moden3/tamanori_robot/CAD/V2/玉乗りロボット.SLDASM

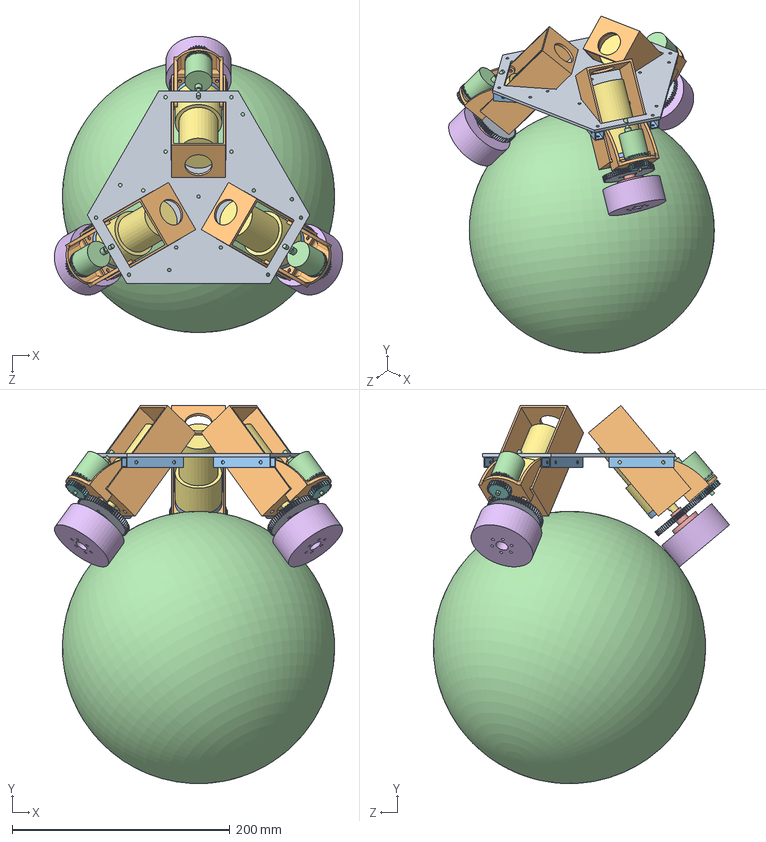
[picture p1: CAD file, 2019-08-27]
CAD/V2/玉乗りロボット.SLDASM
264.7 x 347.1 x 272.0 mm
土台1段目板
モータエンコーダ取り付け角柱 x 3
土台と脚取り付け角柱 x 6
E6A2_CW3C x 3
オムニ用ハブ x 3
オムニホイール x 3
モータ_ツカサ電工 x 3
エンコーダ歯車 x 3
モータ伝達歯車 x 3
エンコーダ取付3D部品 x 3
モータ取り付けアクリル板 x 3
球
