moden3/tamanori_robot/CAD/V2/アクリル用/切り出し用.SLDASM

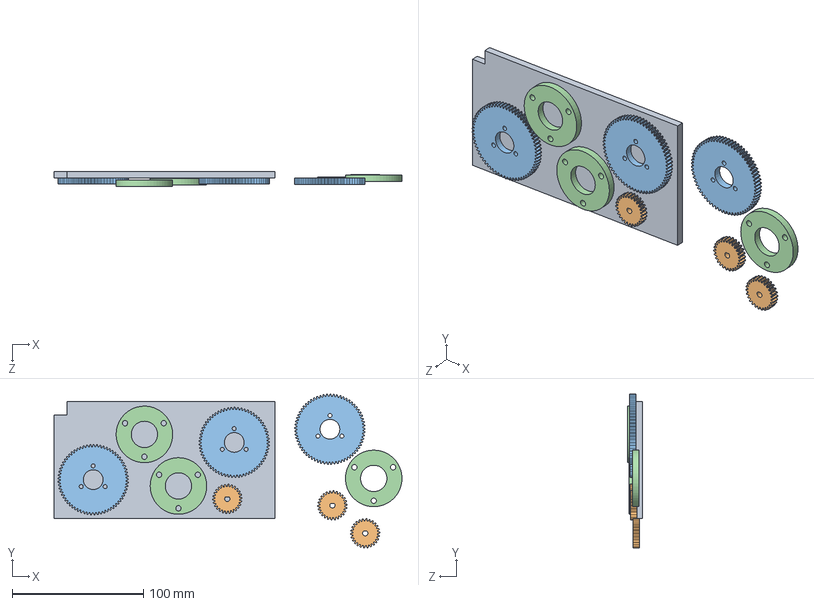
[picture p2: CAD file, 2019-07-12]
CAD/V2/アクリル用/切り出し用.SLDASM
264.7 x 117.1 x 11.4 mm
板1
エンコーダ歯車 x 3
モータ伝達歯車 x 3
モータ取り付けアクリル板 x 3
