moden3/tamanori_robot/CAD/V2/ワイヤ放電用/土台_ワイヤ放電.SLDASM

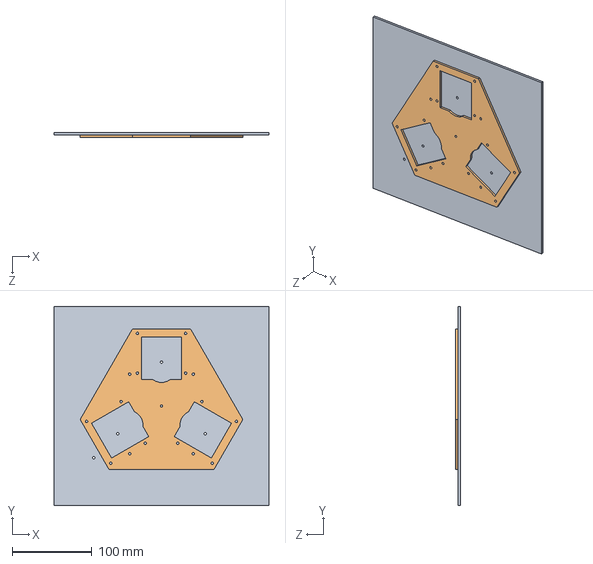
[picture p3: CAD file, 2019-07-12]
CAD/V2/ワイヤ放電用/土台_ワイヤ放電.SLDASM
270.0 x 250.0 x 6.00 mm
土台切り出し用板
土台1段目板
