moden3/tamanori_robot/CAD/V2/脚ユニット.SLDASM

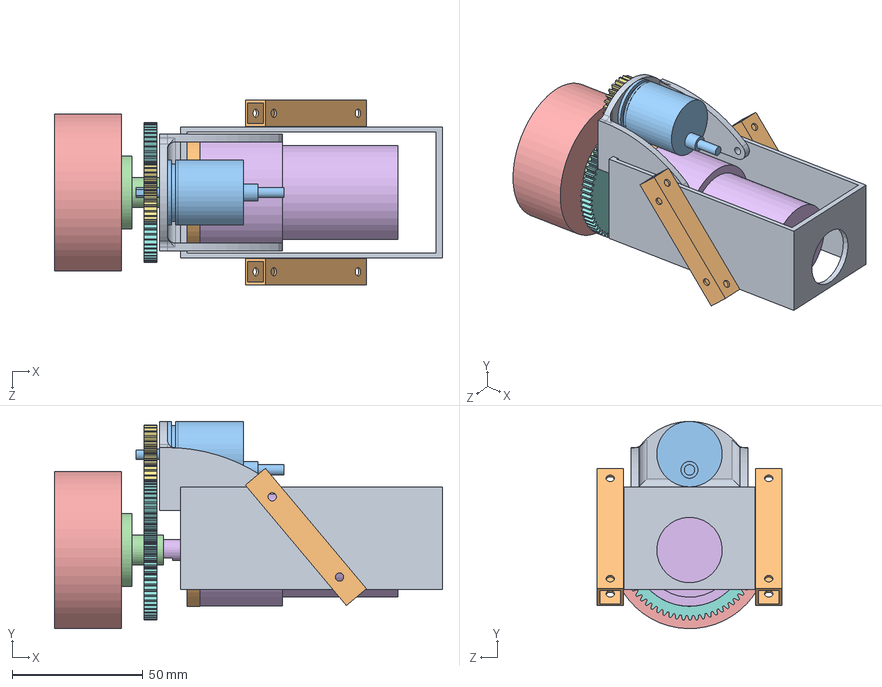
[picture p4: CAD file, 2019-08-19]
CAD/V2/脚ユニット.SLDASM
148.1 x 79.1 x 70.5 mm
モータエンコーダ取り付け角柱
土台と脚取り付け角柱 x 2
E6A2_CW3C
オムニ用ハブ
オムニホイール
モータ_ツカサ電工
エンコーダ歯車
モータ伝達歯車
エンコーダ取付3D部品
モータ取り付けアクリル板
