moden3/tamanori_robot/CAD/V2/ワイヤ放電用/土台切り出し用板.SLDPRT

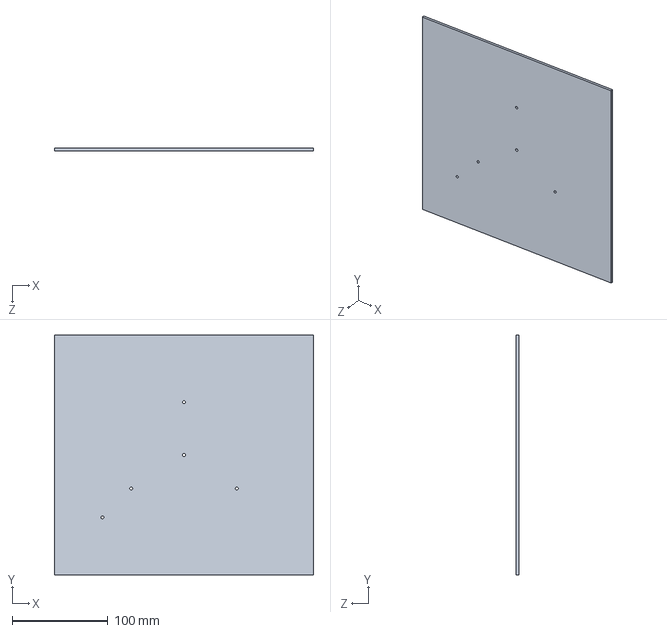
[picture p6: CAD file, 2019-07-12]
CAD/V2/ワイヤ放電用/土台切り出し用板.SLDPRT
270.0 x 250.0 x 3.00 mm
