moden3/tamanori_robot/CAD/V2/球.SLDPRT

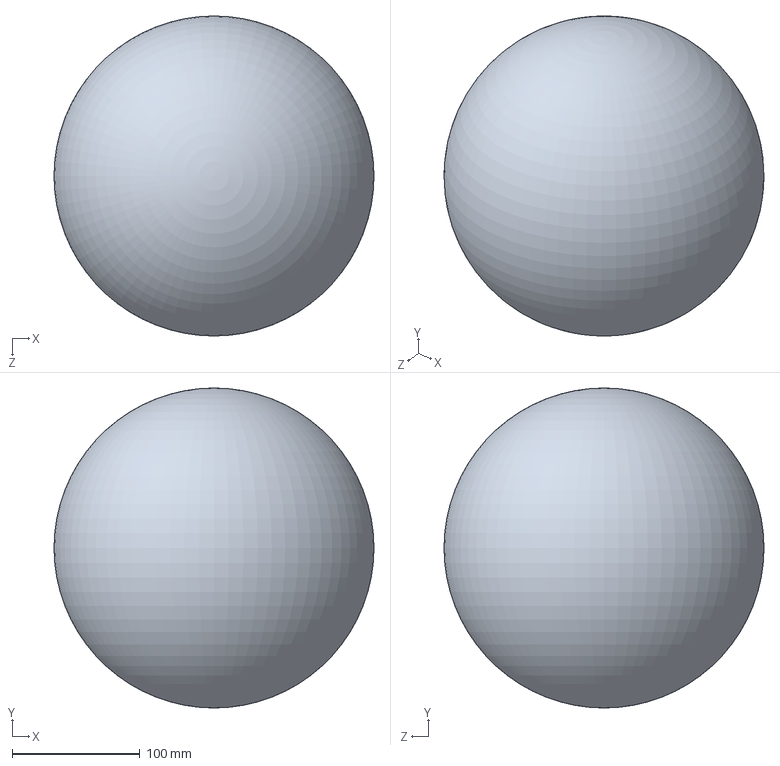
[picture p7: CAD file, 2019-08-27]
CAD/V2/球.SLDPRT
250.0 x 250.0 x 250.0 mm
