moden3/tamanori_robot/CAD/V2/アクリル用/切り出し用_V3.DXF

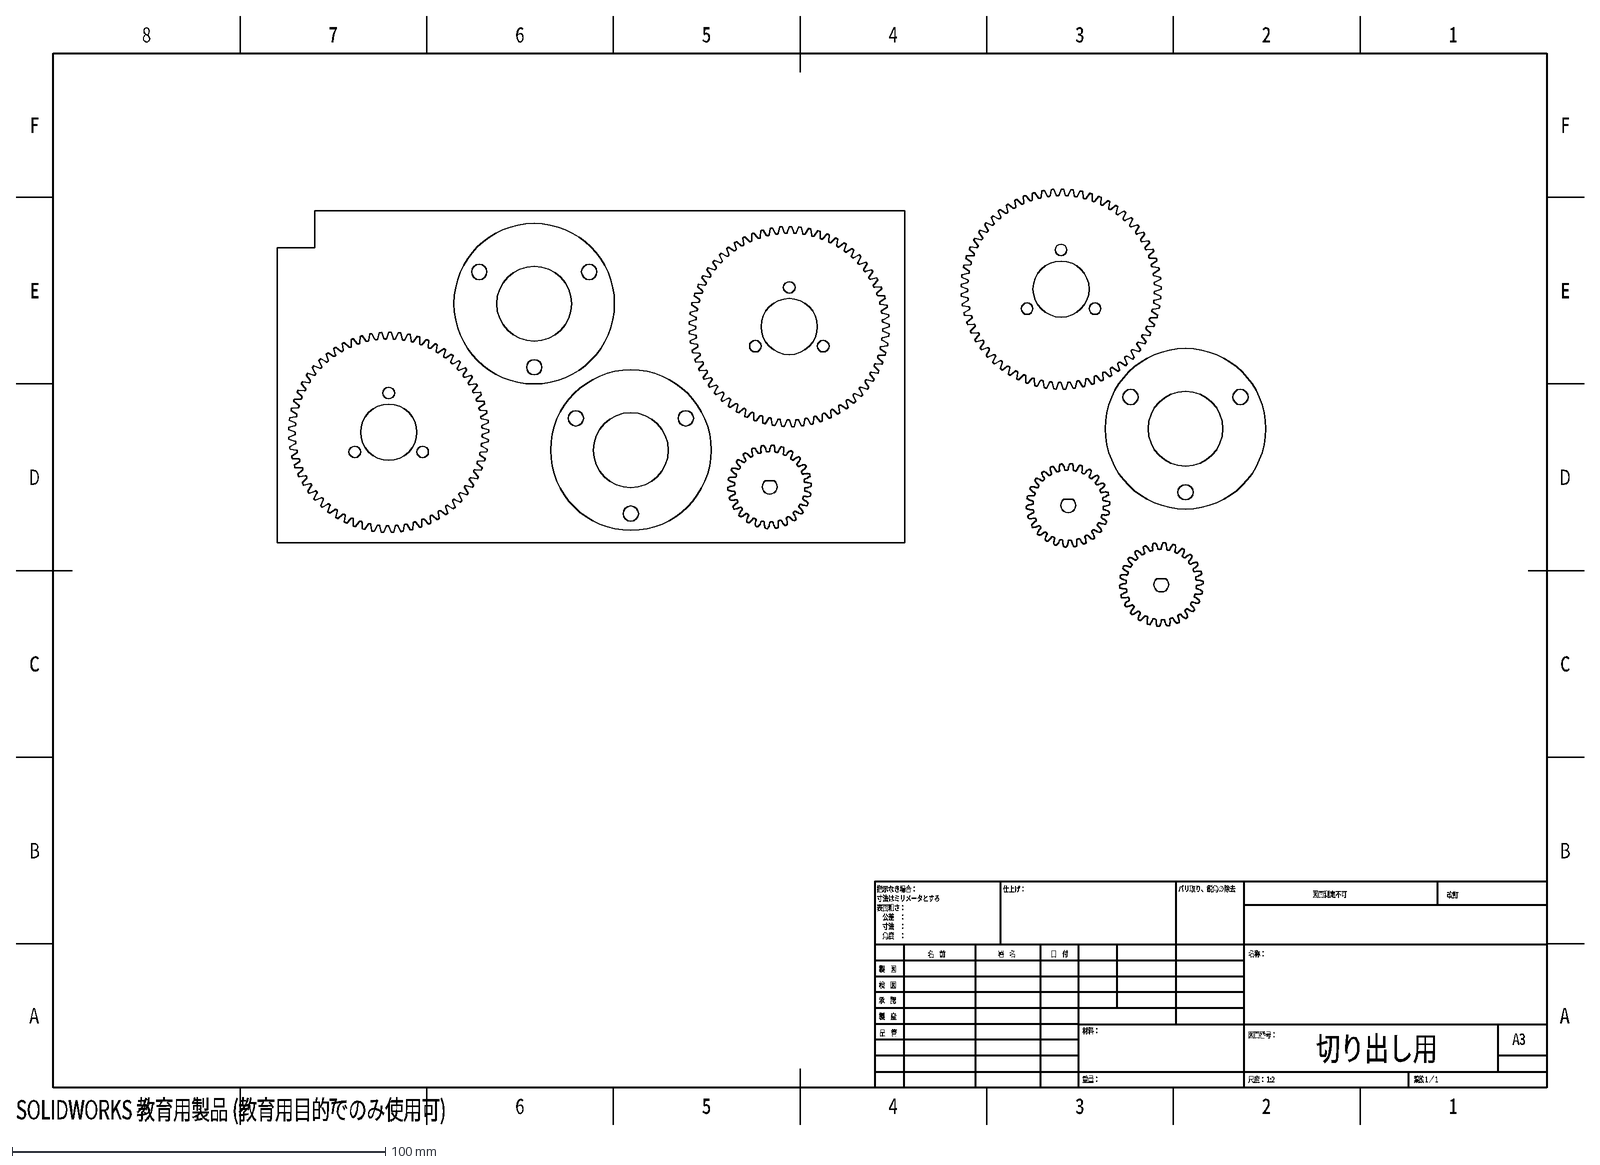
[picture p8: CAD file, 2019-07-12]
CAD/V2/アクリル用/切り出し用_V3.DXF
A
B
C
D
E
F
8
7
6
5
4
3
2
1
切り出し用
重量：
A3
葉数 1 ／ 1
尺度： 1:2
図面番号：
名称：
改訂
図面測定不可
材料：
日 付
署 名
名 前
バリ取り、鋭角の除去
仕上げ：
指示なき場合：
寸法はミリメータとする
表面粗さ：
公差 ：
寸法 ：
角度 ：
品 管
製 産
承 認
検 図
製 図
SOLIDWORKS 教育用製品 (教育用目的でのみ使用可)
