moden3/tamanori_robot/CAD/V2/ワイヤ放電用/土台_ワイヤ放電用.DXF

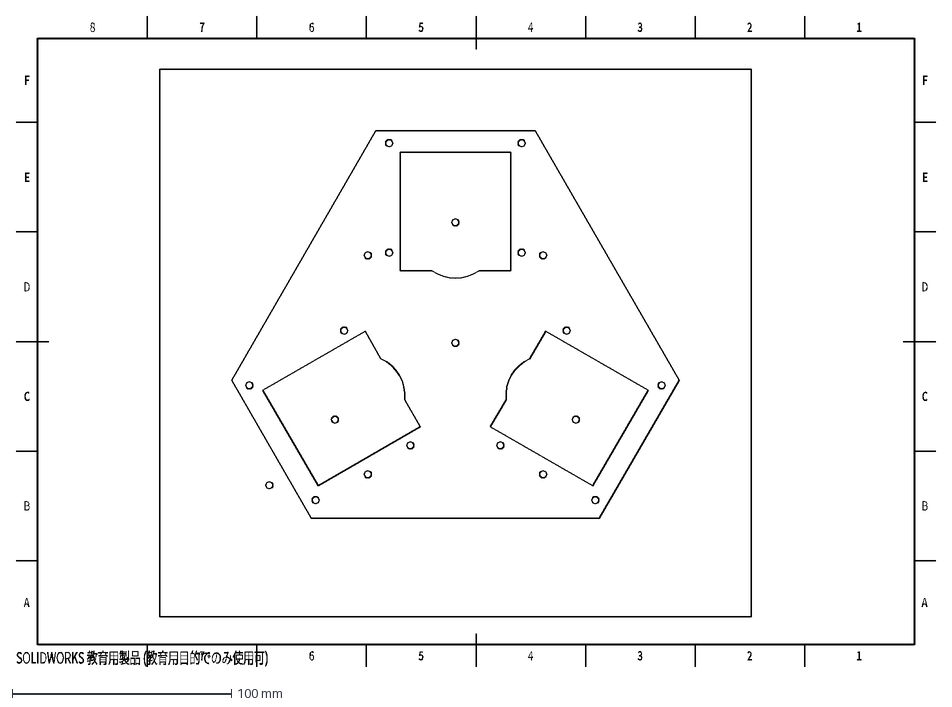
[picture p9: CAD file, 2019-07-12]
CAD/V2/ワイヤ放電用/土台_ワイヤ放電用.DXF
A
B
C
D
E
F
8
7
6
5
4
3
2
1
SOLIDWORKS 教育用製品 (教育用目的でのみ使用可)
