moden3/tamanori_robot/CAD/V2/土台2段目板.SLDPRT

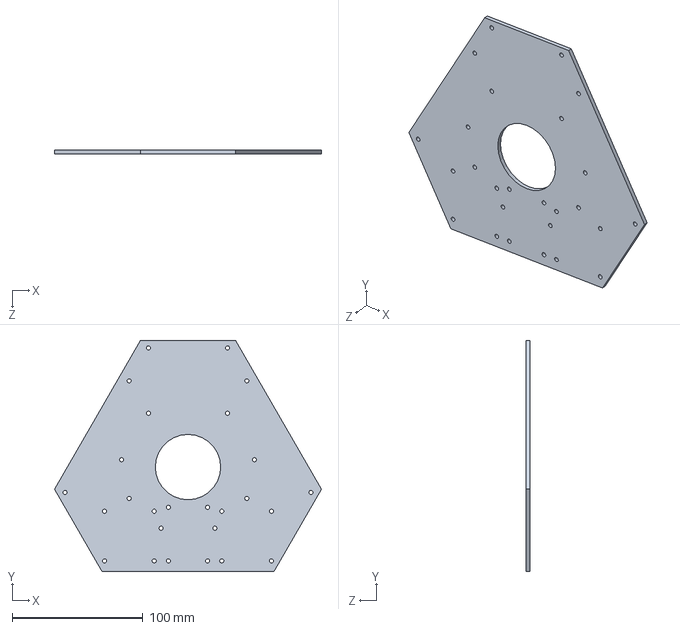
[picture p10: CAD file, 2019-08-19]
CAD/V2/土台2段目板.SLDPRT
204.3 x 177.0 x 3.00 mm
