moden3/tamanori_robot/CAD/V2/アクリル用/板1.SLDPRT

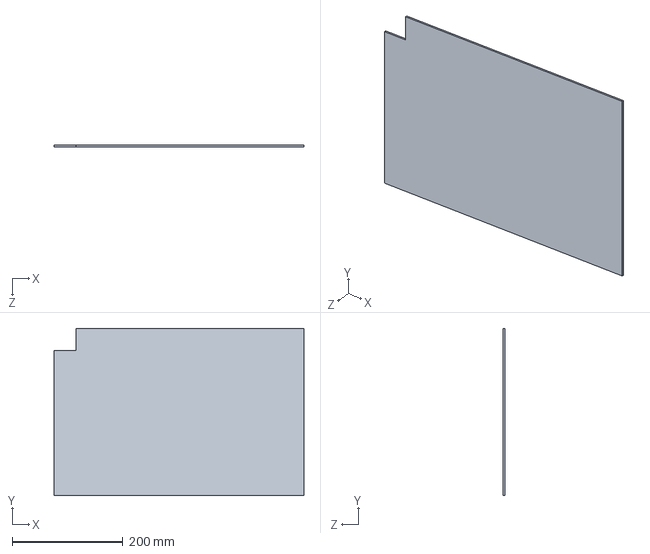
[picture p12: CAD file, 2019-07-04]
CAD/V2/アクリル用/板1.SLDPRT
452.0 x 302.0 x 3.00 mm
