moden3/tamanori_robot/CAD/V2/エンコーダ取付3D部品.SLDPRT

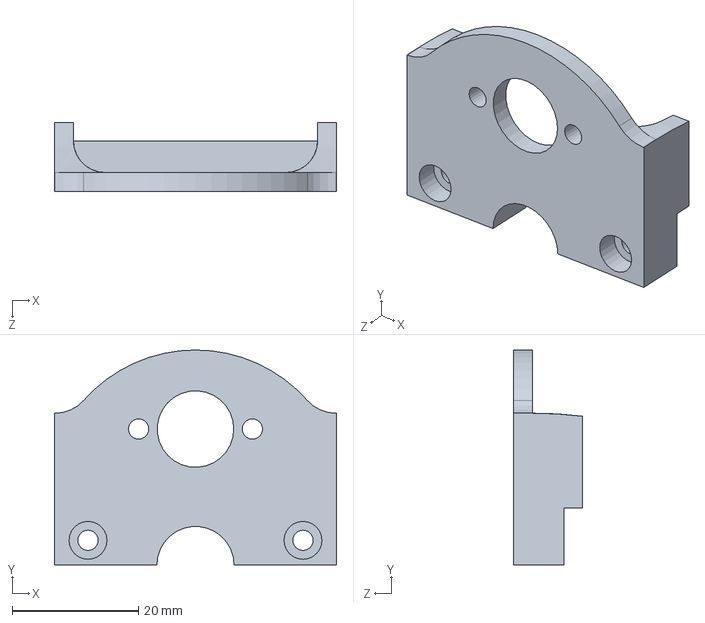
[picture p14: CAD file, 2019-08-19]
CAD/V2/エンコーダ取付3D部品.SLDPRT
44.6 x 34.0 x 10.9 mm
