moden3/tamanori_robot/CAD/V2/モータエンコーダ取り付け角柱.SLDPRT

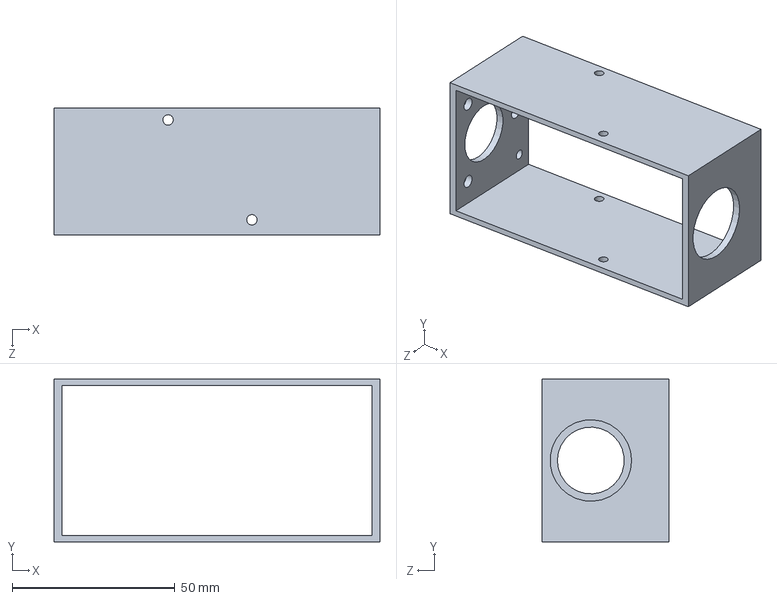
[picture p15: CAD file, 2019-07-12]
CAD/V2/モータエンコーダ取り付け角柱.SLDPRT
100.0 x 50.0 x 39.0 mm
