moden3/tamanori_robot/CAD/V2/モータ伝達歯車.SLDPRT

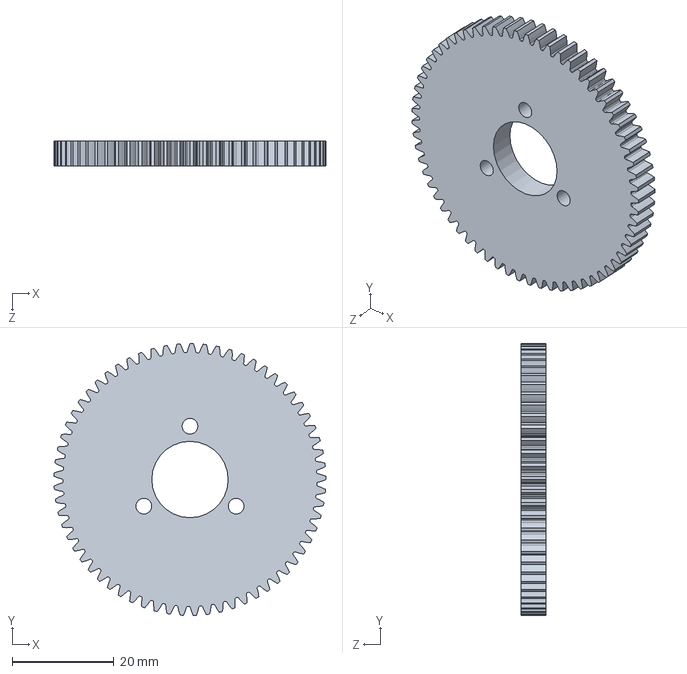
[picture p16: CAD file, 2019-07-04]
CAD/V2/モータ伝達歯車.SLDPRT
53.6 x 53.6 x 5.00 mm
