moden3/tamanori_robot/CAD/V2/エンコーダ歯車.SLDPRT

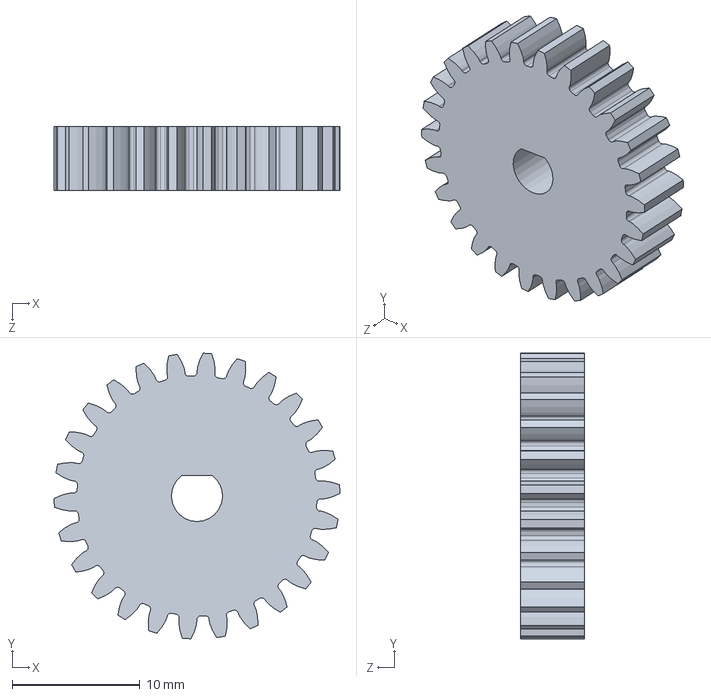
[picture p17: CAD file, 2019-07-04]
CAD/V2/エンコーダ歯車.SLDPRT
22.4 x 22.4 x 5.00 mm
