moden3/tamanori_robot/CAD/V2/1-36.1-75.SLDPRT

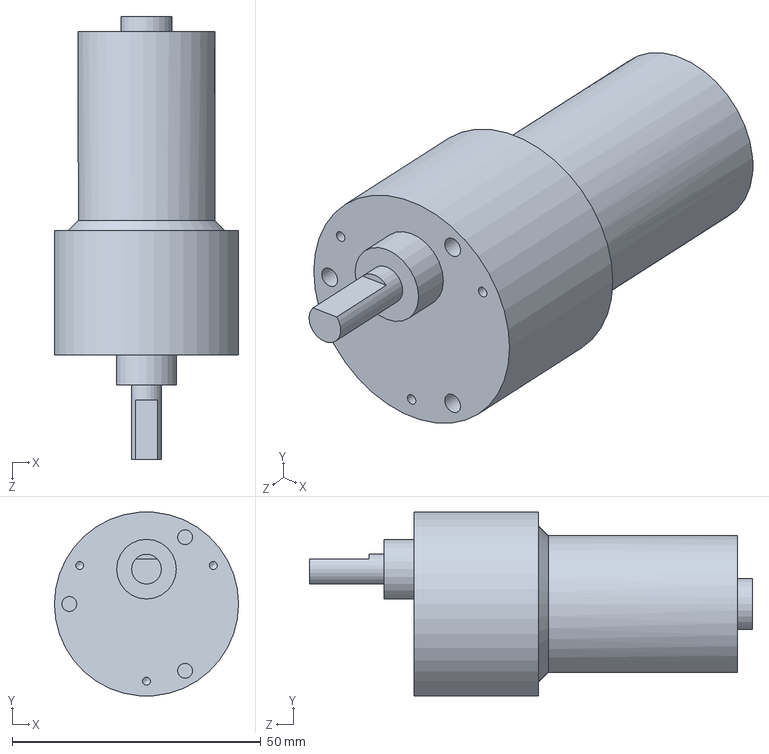
[picture p18: CAD file, 2019-07-04]
CAD/V2/1-36.1-75.SLDPRT
37.0 x 36.9 x 89.0 mm
