moden3/tamanori_robot/CAD/V2/土台と脚取り付け角柱.SLDPRT

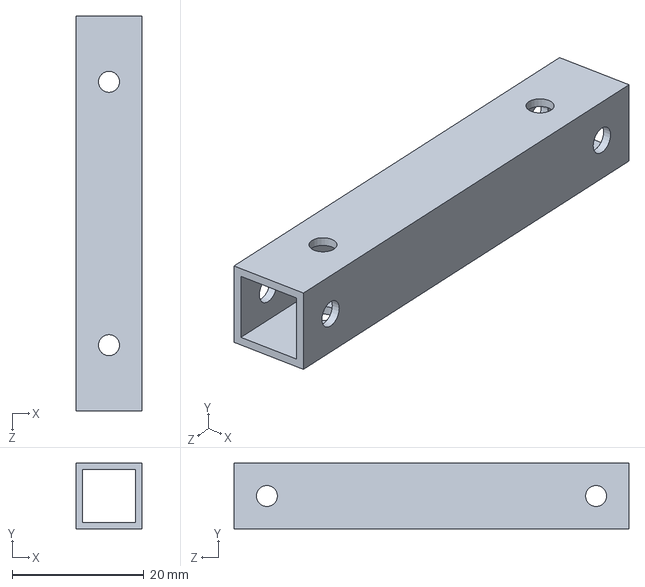
[picture p19: CAD file, 2019-07-04]
CAD/V2/土台と脚取り付け角柱.SLDPRT
10.0 x 10.0 x 60.0 mm
