moden3/tamanori_robot/CAD/V2/E6A2_CW3C.SLDPRT

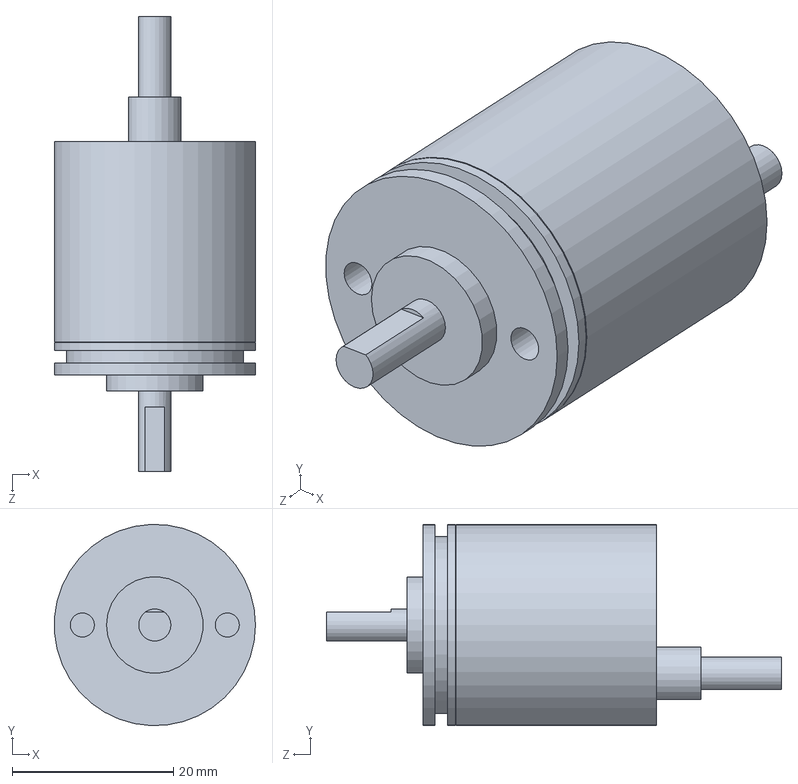
[picture p20: CAD file, 2019-07-04]
CAD/V2/E6A2_CW3C.SLDPRT
25.0 x 25.0 x 56.5 mm
