moden3/tamanori_robot/CAD/V2/モータ取り付けアクリル板.SLDPRT

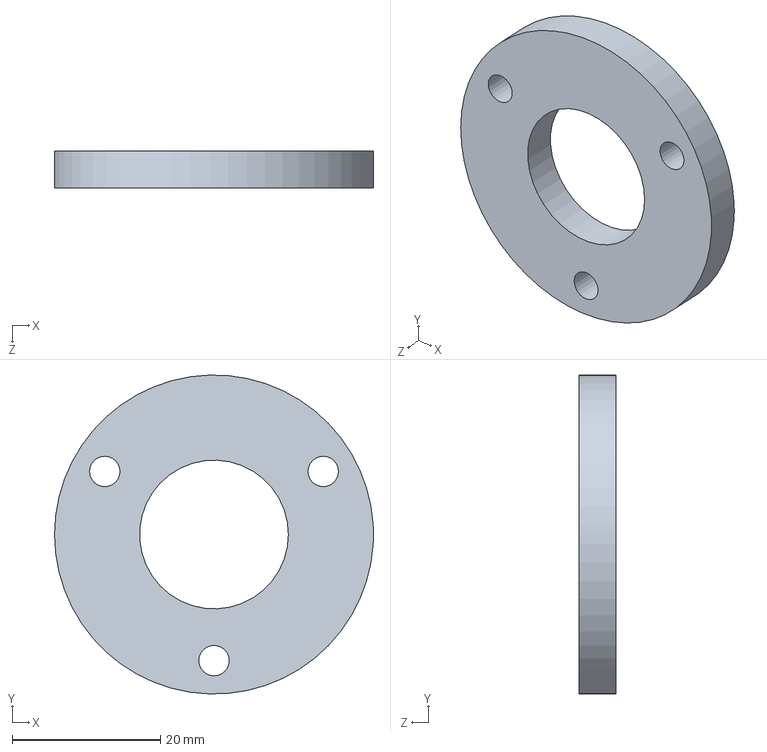
[picture p21: CAD file, 2019-07-04]
CAD/V2/モータ取り付けアクリル板.SLDPRT
43.0 x 43.0 x 5.00 mm
