moden3/tamanori_robot/CAD/V2/モータ_ツカサ電工.SLDPRT

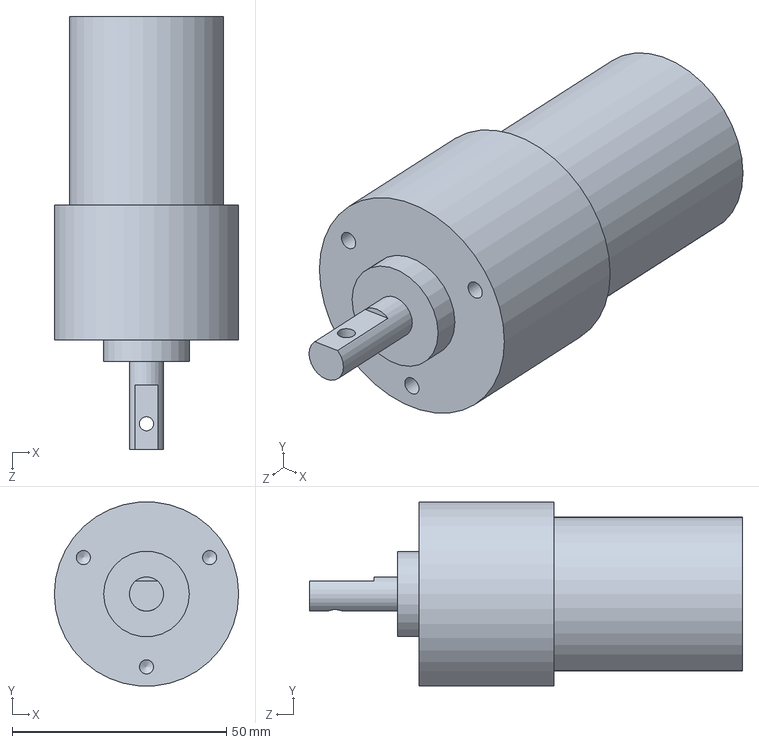
[picture p22: CAD file, 2019-07-04]
CAD/V2/モータ_ツカサ電工.SLDPRT
43.0 x 42.9 x 101.0 mm
