moden3/tamanori_robot/CAD/V2/オムニホイール.SLDPRT

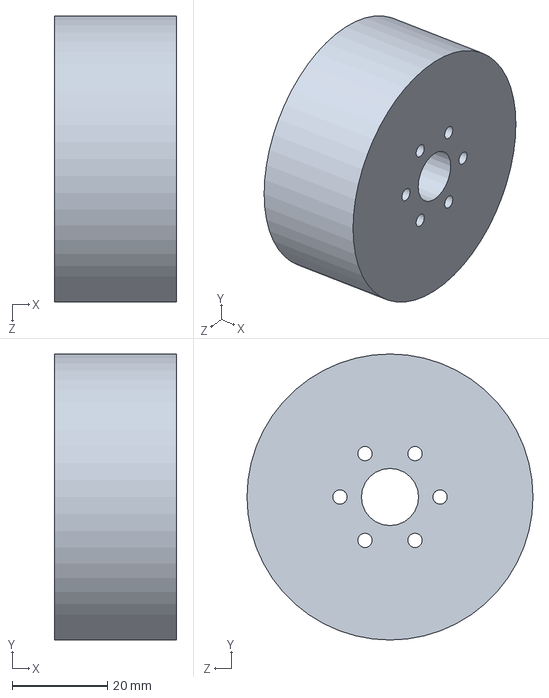
[picture p23: CAD file, 2019-07-04]
CAD/V2/オムニホイール.SLDPRT
25.6 x 60.0 x 60.0 mm
