moden3/tamanori_robot/CAD/V2/オムニ用ハブ.SLDPRT

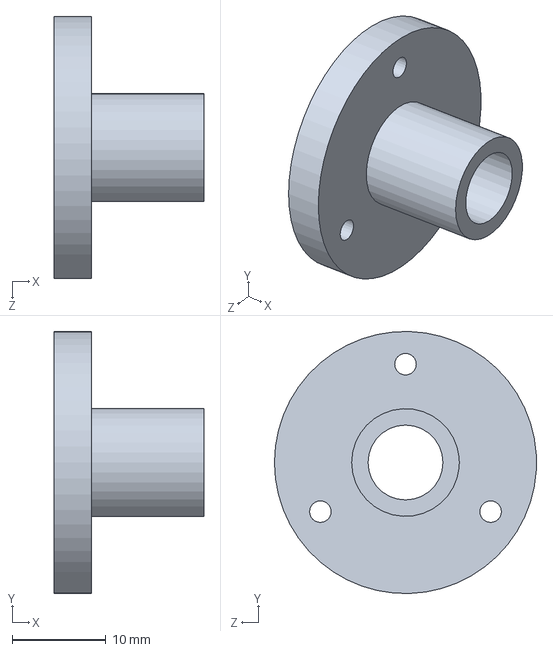
[picture p24: CAD file, 2019-07-04]
CAD/V2/オムニ用ハブ.SLDPRT
16.0 x 28.0 x 28.0 mm
