moden3/tamanori_robot/(list of files, cad)

Other CAD files:
CAD/V1/モーター取り付け.SLDPRT
CAD/V1/土台1段目板.SLDPRT
CAD/V1/斜め取り付け角柱.SLDPRT
CAD/V1/玉乗りロボット.SLDASM
CAD/V2/アクリル用/切り出し用.DXF
CAD/V2/エンコーダ取付3D部品.STL
CAD/V2/ワイヤ放電用/土台_ワイヤ放電.SLDDRW
CAD/V2/土台2段目板.SLDDRW
