moden3/tamanori_robot/CAD/V2/土台2段目板.PDF

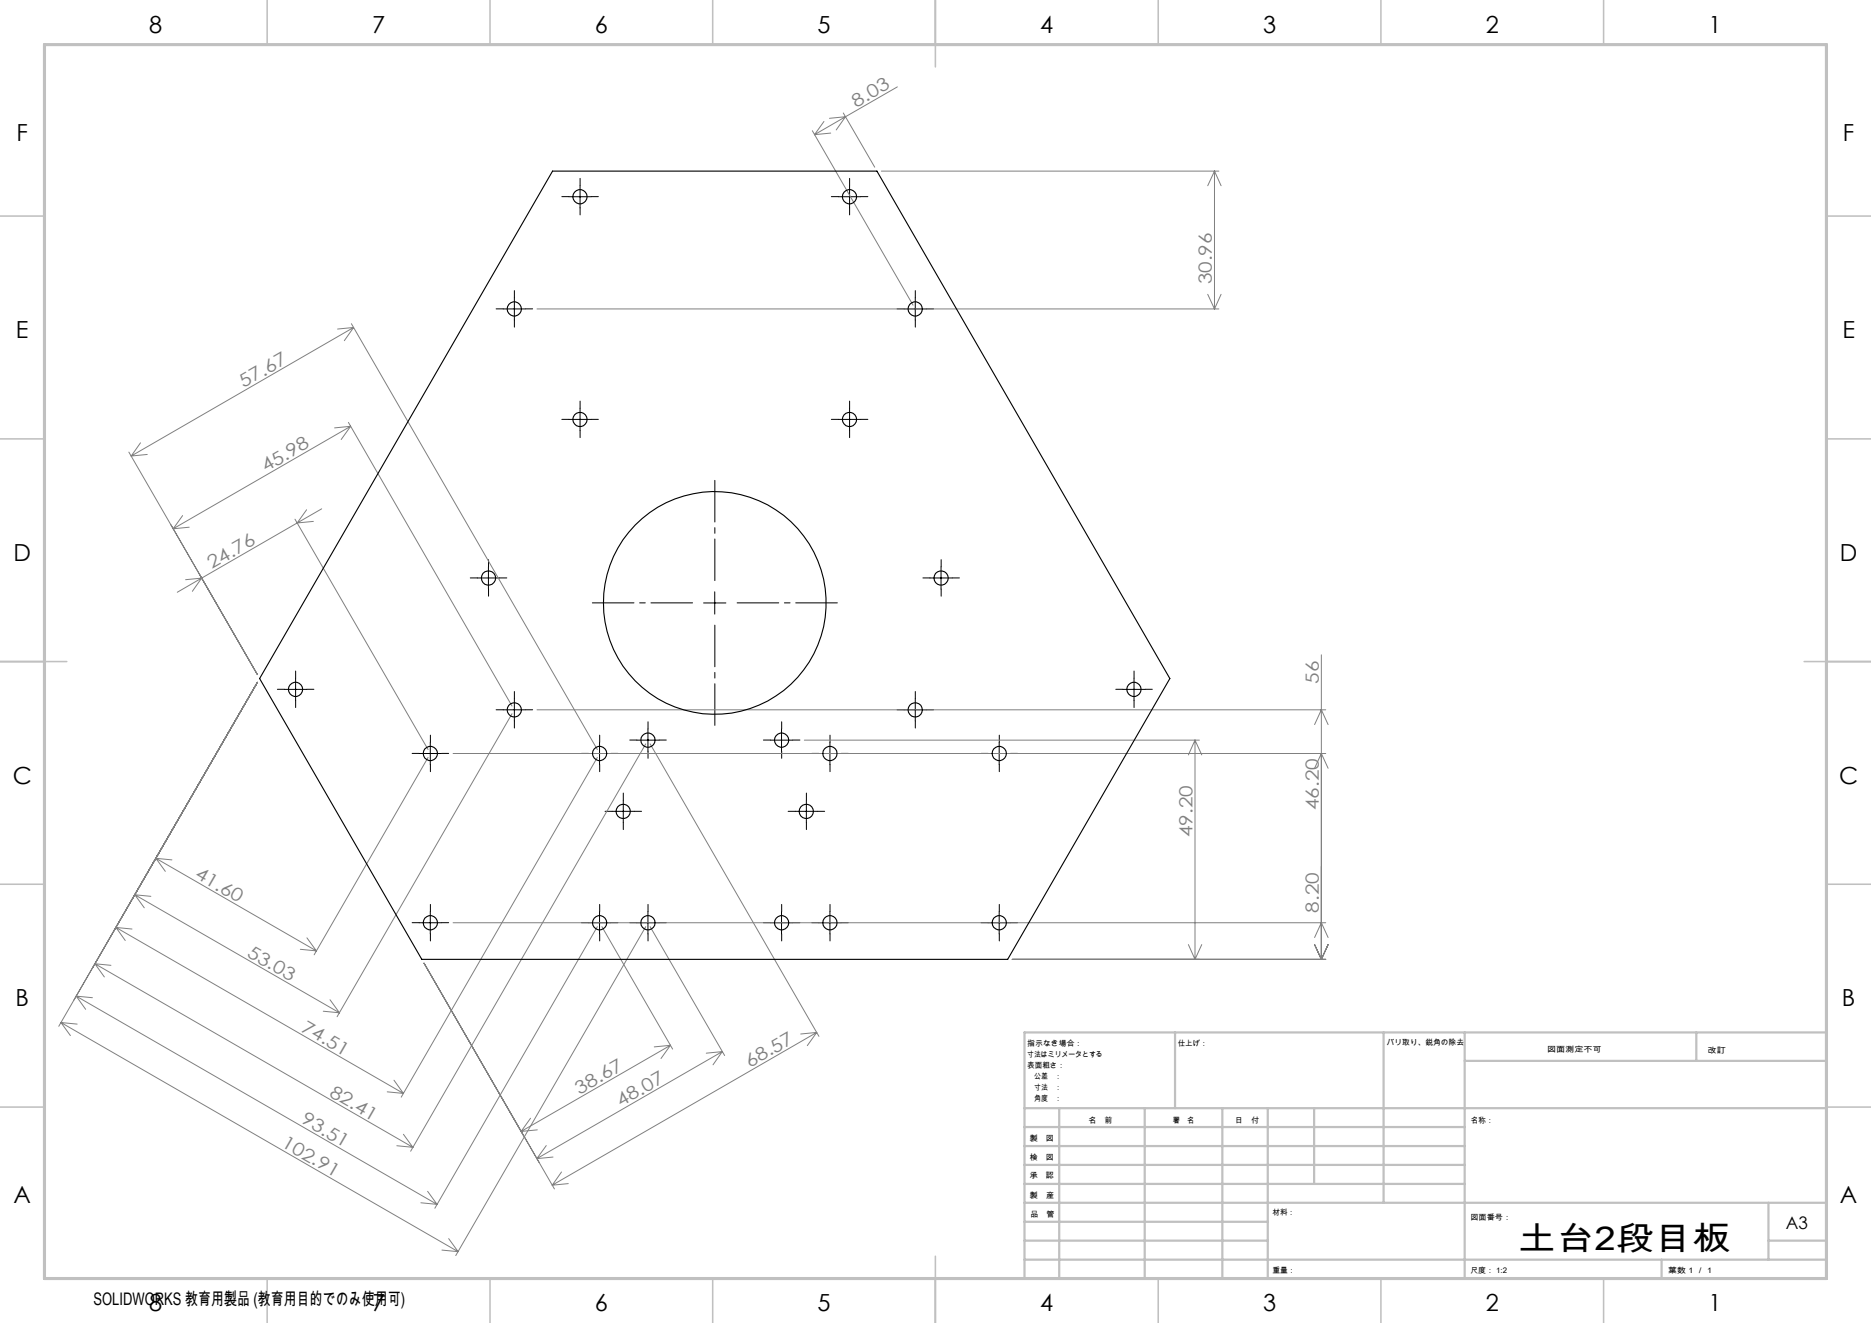
[picture p41: page 1]

製　図
検　図
承　認
製　産
品　管 | | | | 材料： | 図面番号： 土台2段目板 重量： | A3

SOLIDWORKS 教育用製品 (教育用目的でのみ使用可)
