moden3/tamanori_robot/CAD/V2/ワイヤ放電用/土台_ワイヤ放電.PDF

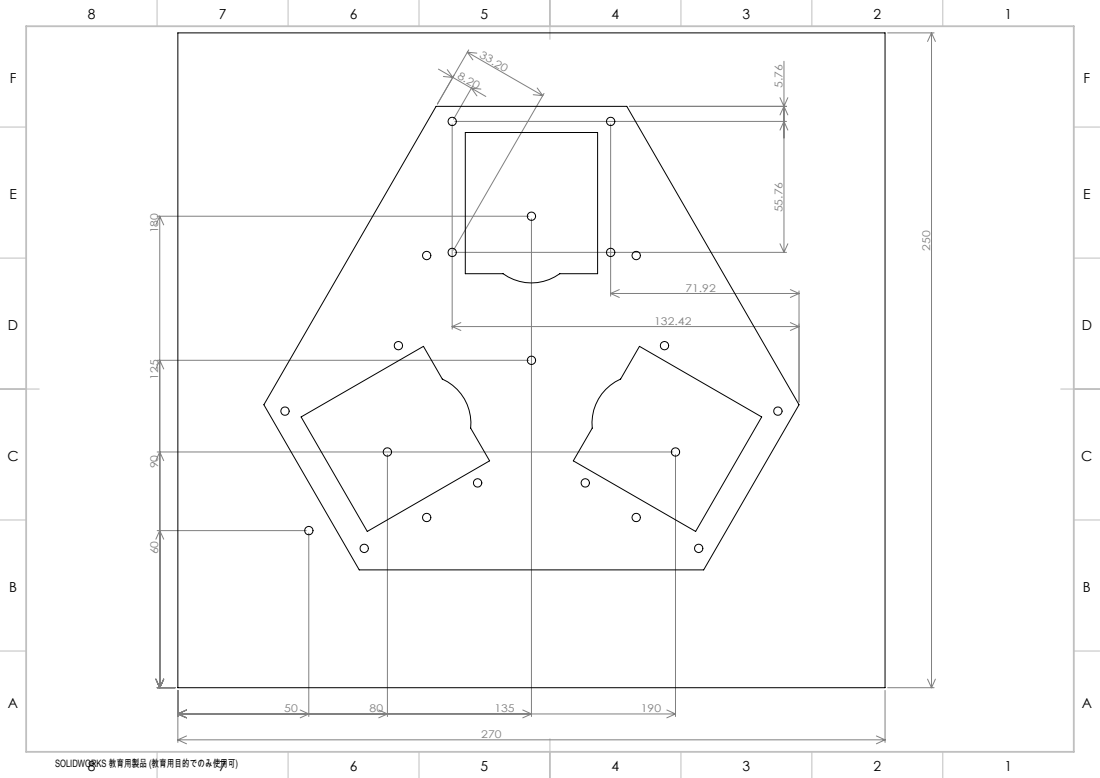
[picture p42: page 1]

SOLIDWORKS 教育用製品 (教育用目的でのみ使用可)

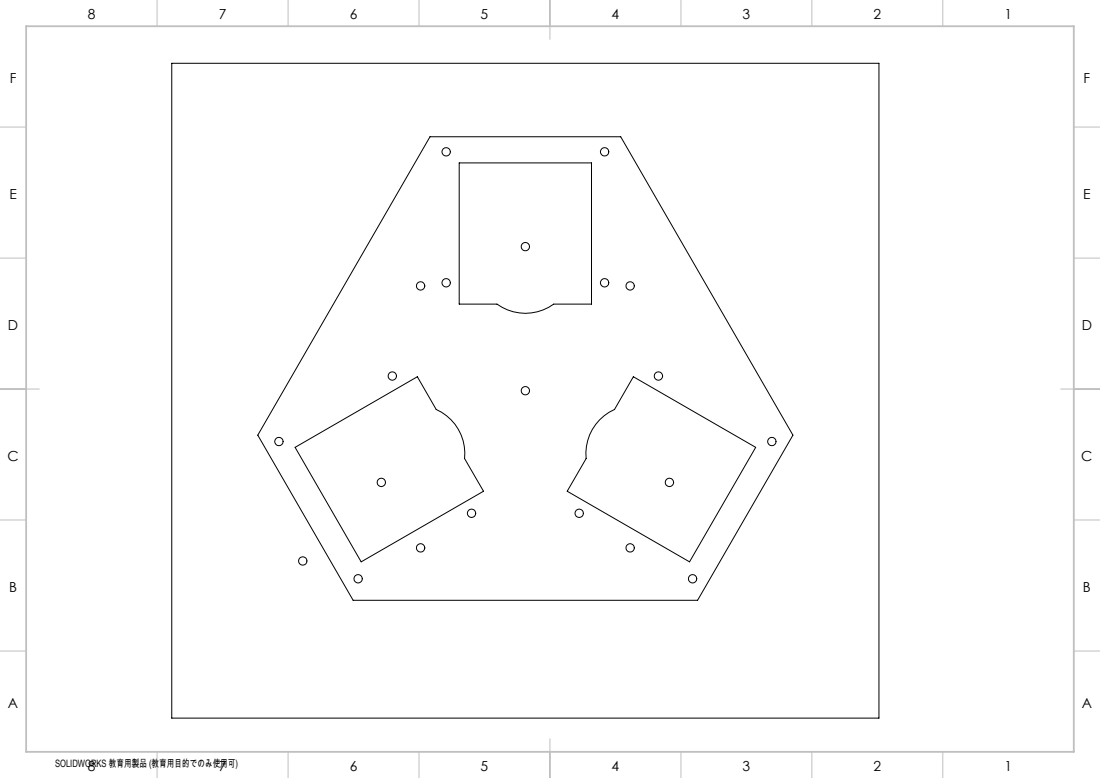
[picture p43: page 2]

SOLIDWORKS 教育用製品 (教育用目的でのみ使用可)
