moden3/tamanori_robot/(commit log)

2019-08-07 08072144 add_dxf_file
    [エンコーダ取付3D部品.SLDPRT, 土台1段目板.SLDPRT, 土台2段目板.DXF, 土台2段目板.SLDPRT, 土台_ワイヤ放電.SLDDRW, 玉乗りロボット.SLDASM, 球.SLDPRT, 脚ユニット.SLDASM]
2019-08-19 08191206 source_code
    [土台2段目板.SLDDRW, 土台2段目板.SLDPRT, 玉乗りロボット.SLDASM, 球.SLDPRT]
